pal73/FAT90/OUT_DOCS/1/1.png

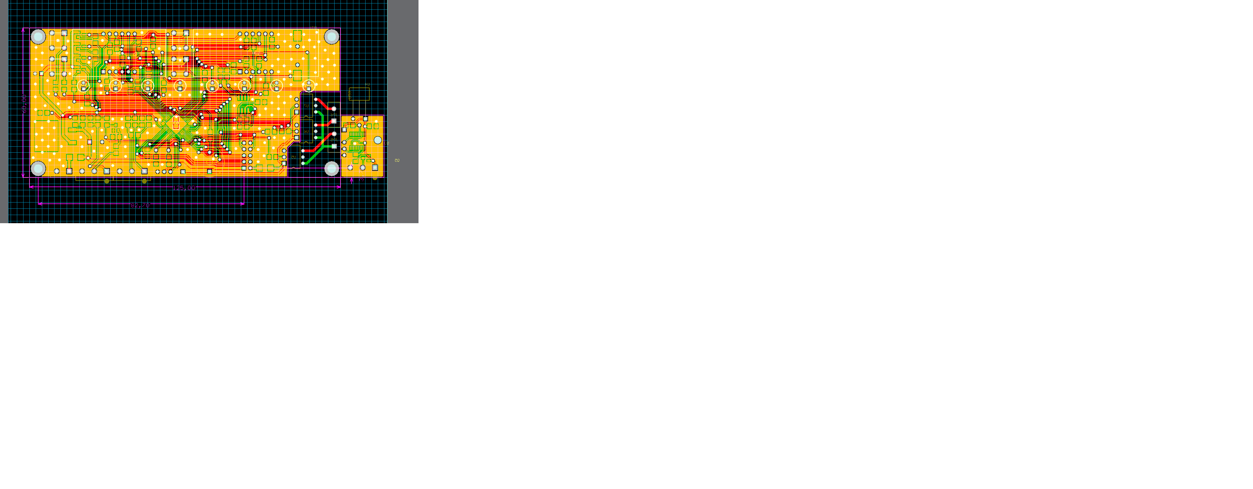
OUT_DOCS/1/1.png
