pal73/FAT90/OUT_DOCS/1/2.png

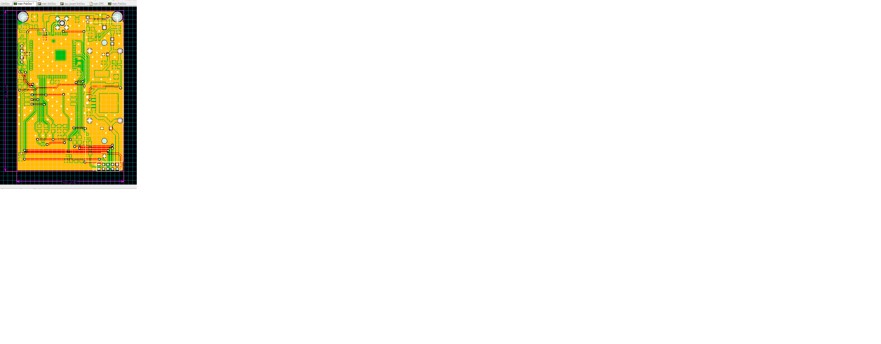
OUT_DOCS/1/2.png
