pal73/FAT90/(list of files, cad)

Other CAD files:
SOFT/dat/fat90_dat.stp
SOFT/kontr/fat90_kontr.stp
