pal73/FAT90/OUT_DOCS/1/7.pdf

NETLIGHT | 52 GND | 53 GND | 54 VBAT | 55 VBAT | 56 VBAT | 57 GND | 58 GND | 59 RF_ANT | 60 GND | 61 GND | 62 GND | 63 GNd | 64 GND | 65 STATUS | 66 GPIO11 | 67 GPIO12 | 68

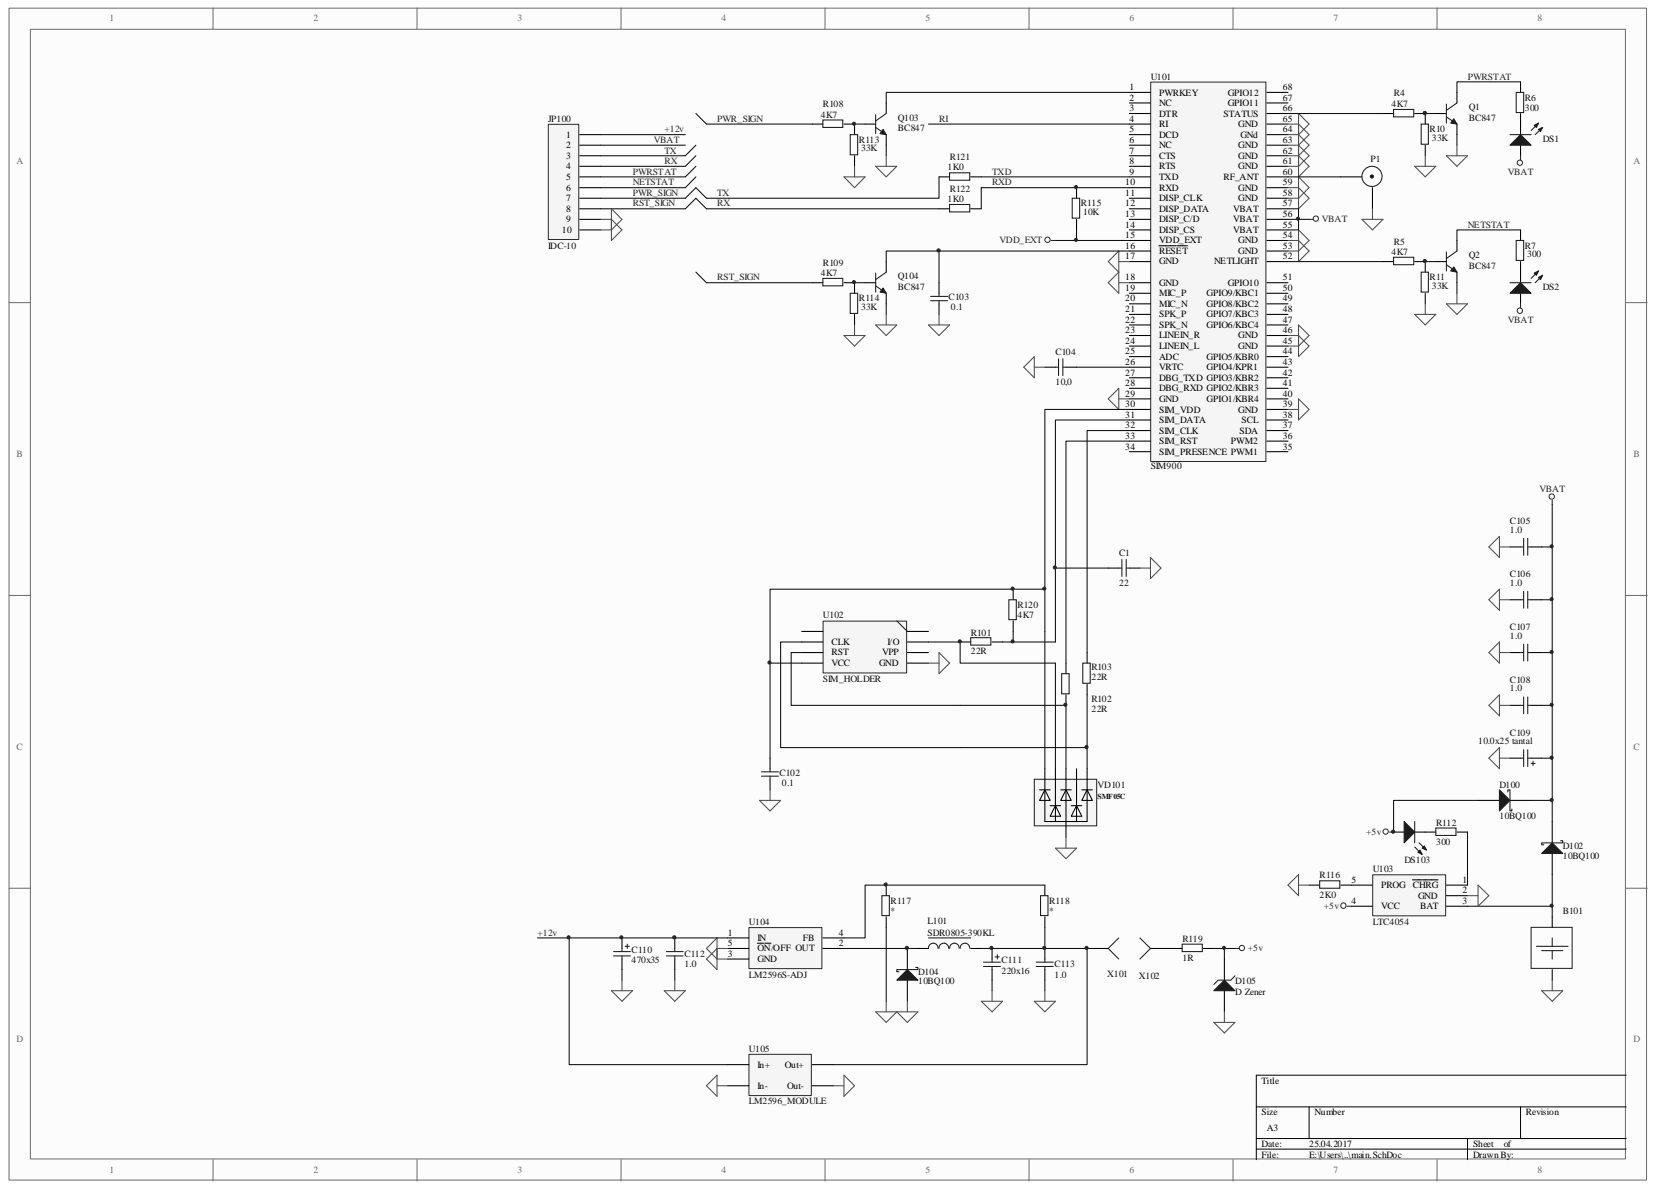
[picture p3: page 1]
