pal73/FAT90/OUT_DOCS/Thermo.PDF

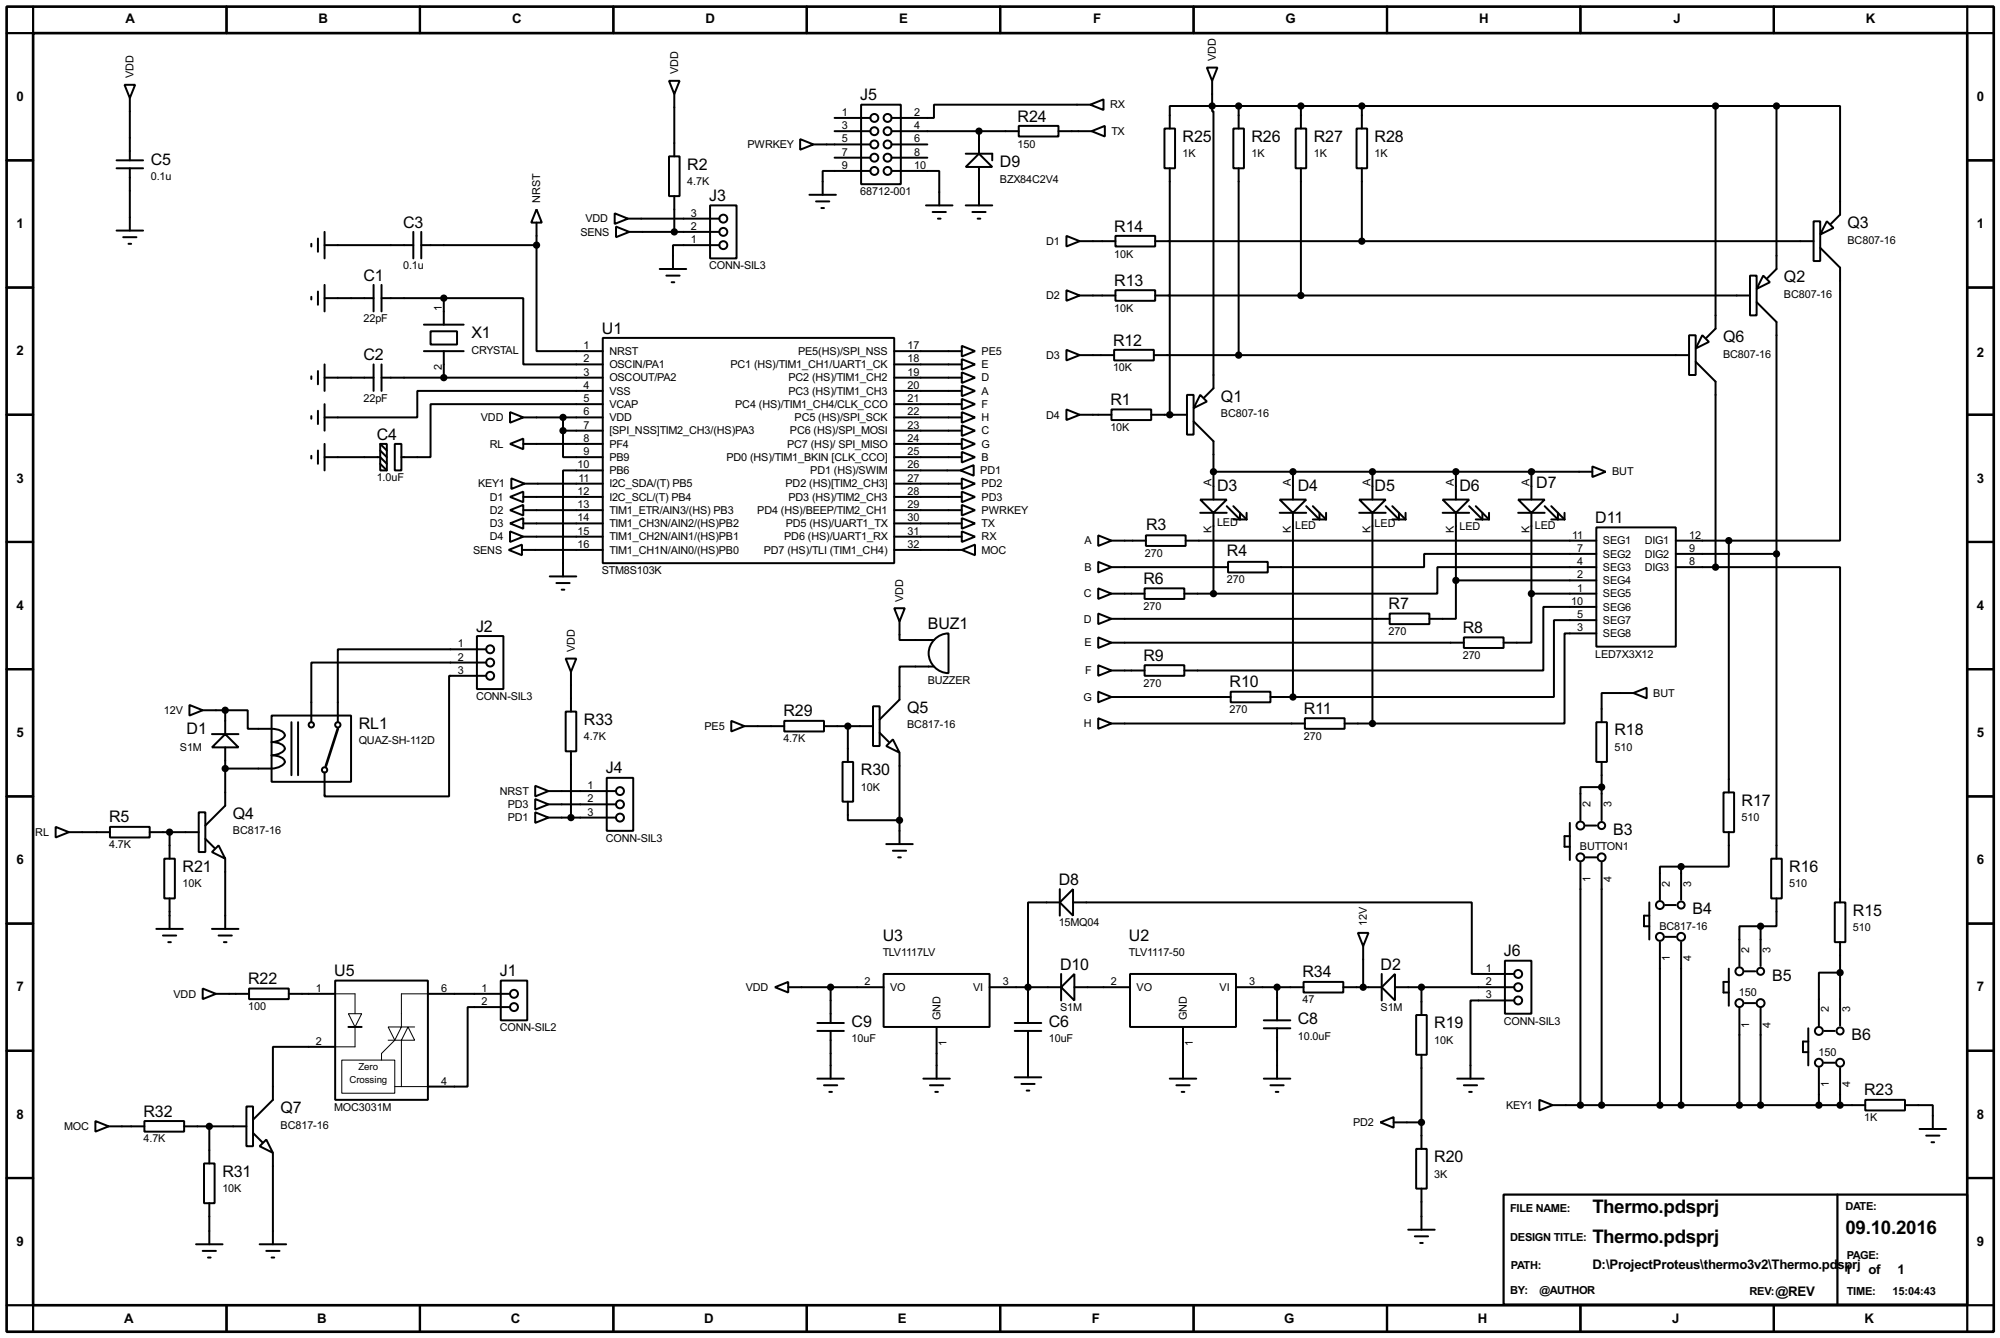
[picture p4: page 1]

FILE NAME:
DESIGN TITLE: Thermo.pdsprj
