pal73/FAT90/OUT_DOCS/1/3.pdf

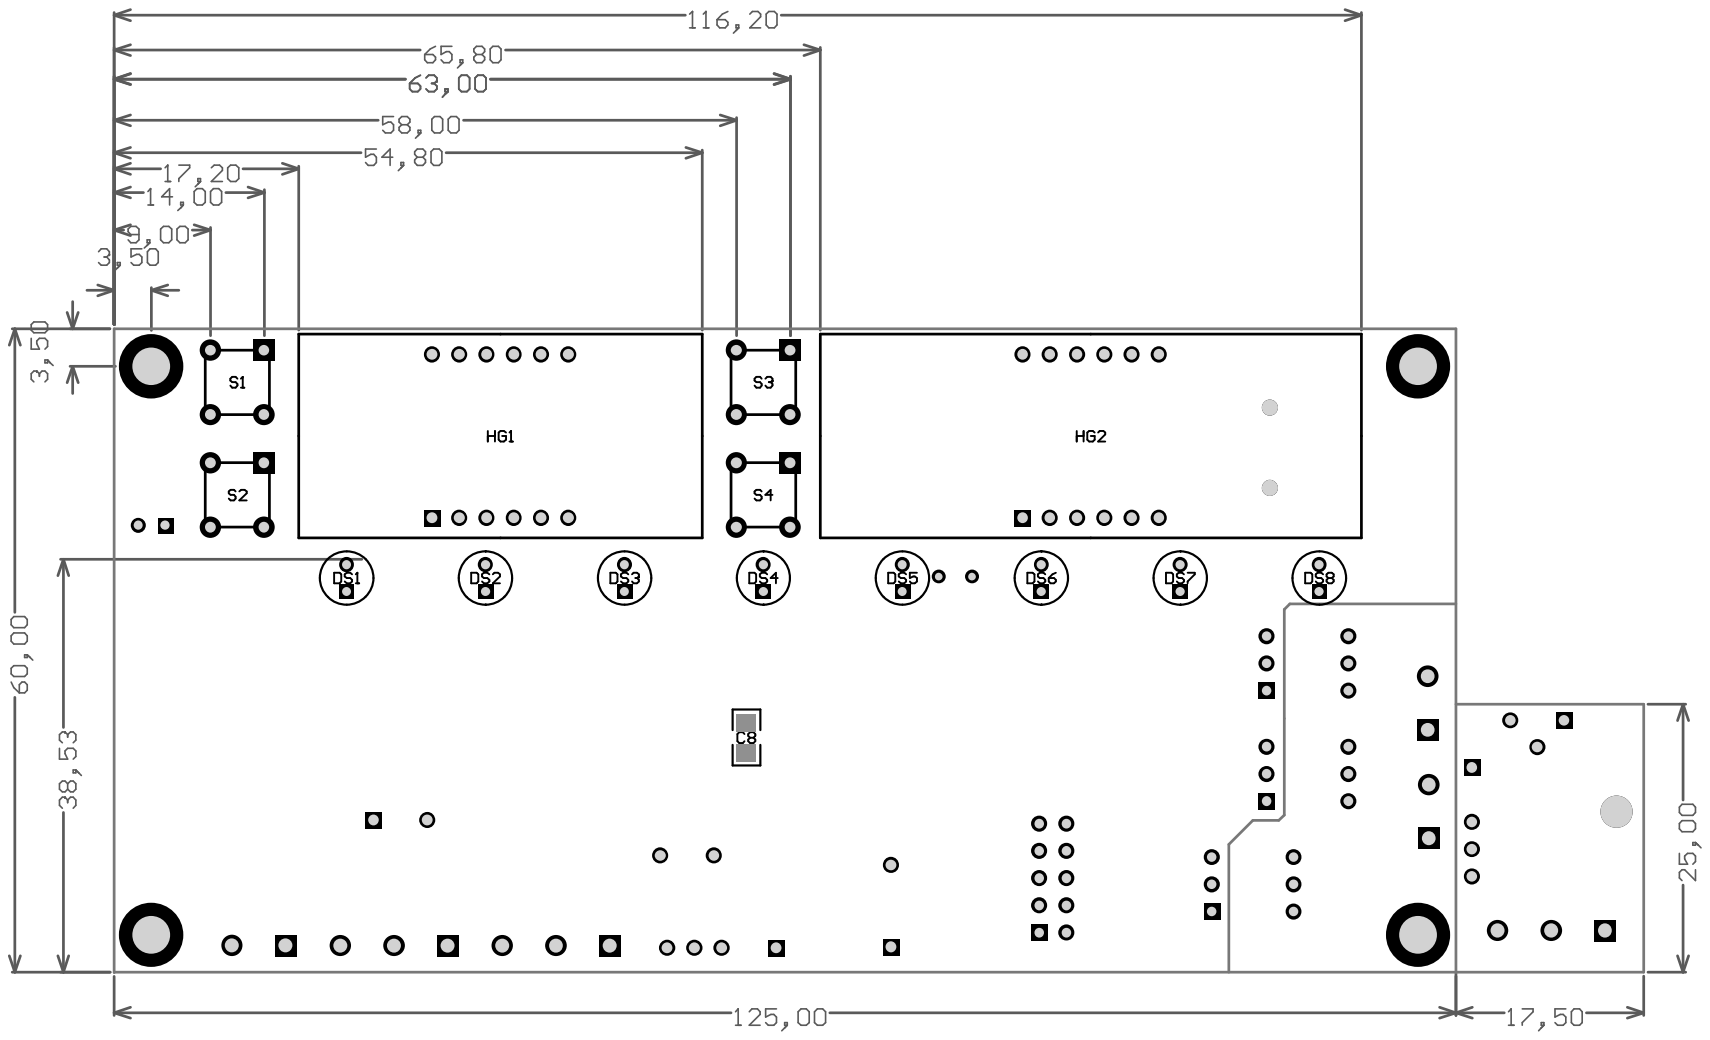
[picture p5: page 1]

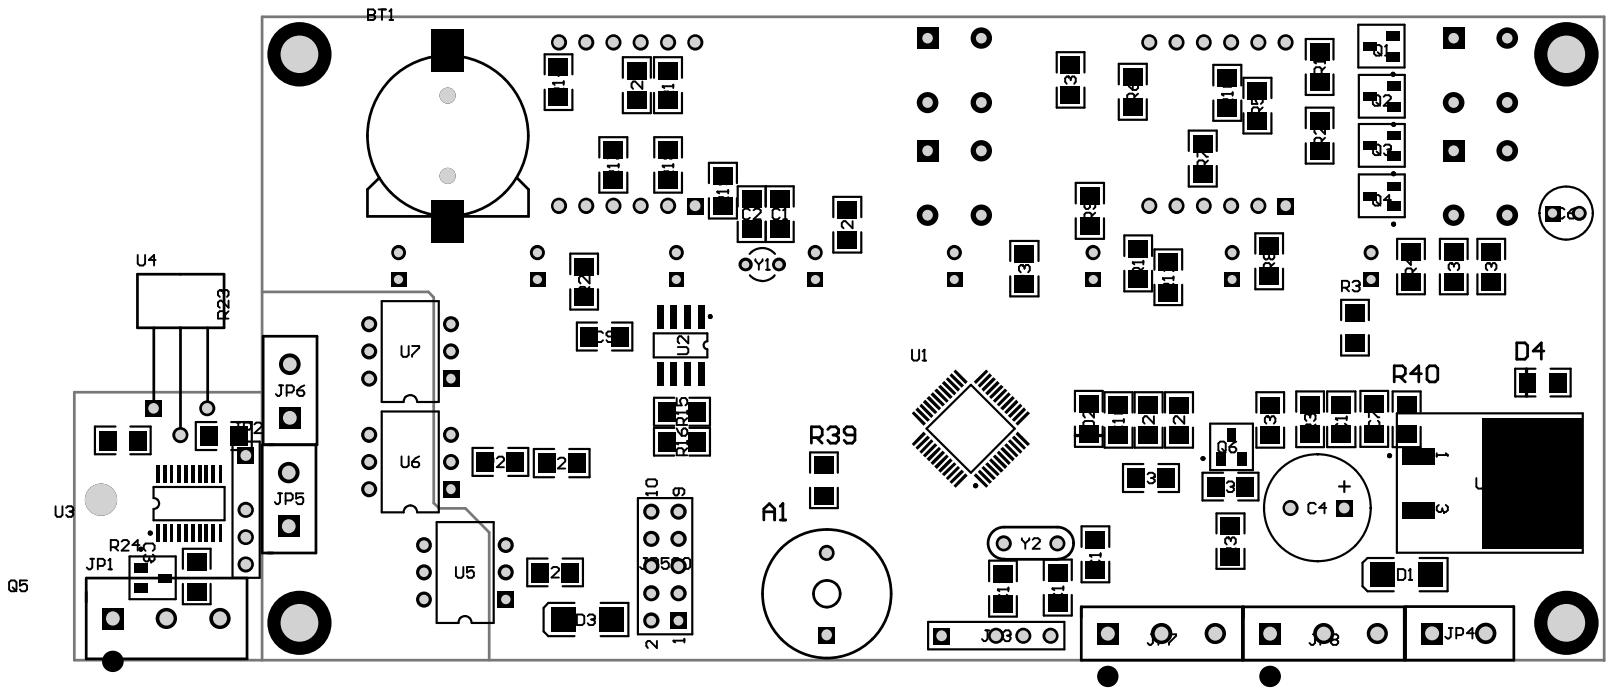
[picture p6: page 2]
