pal73/FAT90/OUT_DOCS/1/4.pdf

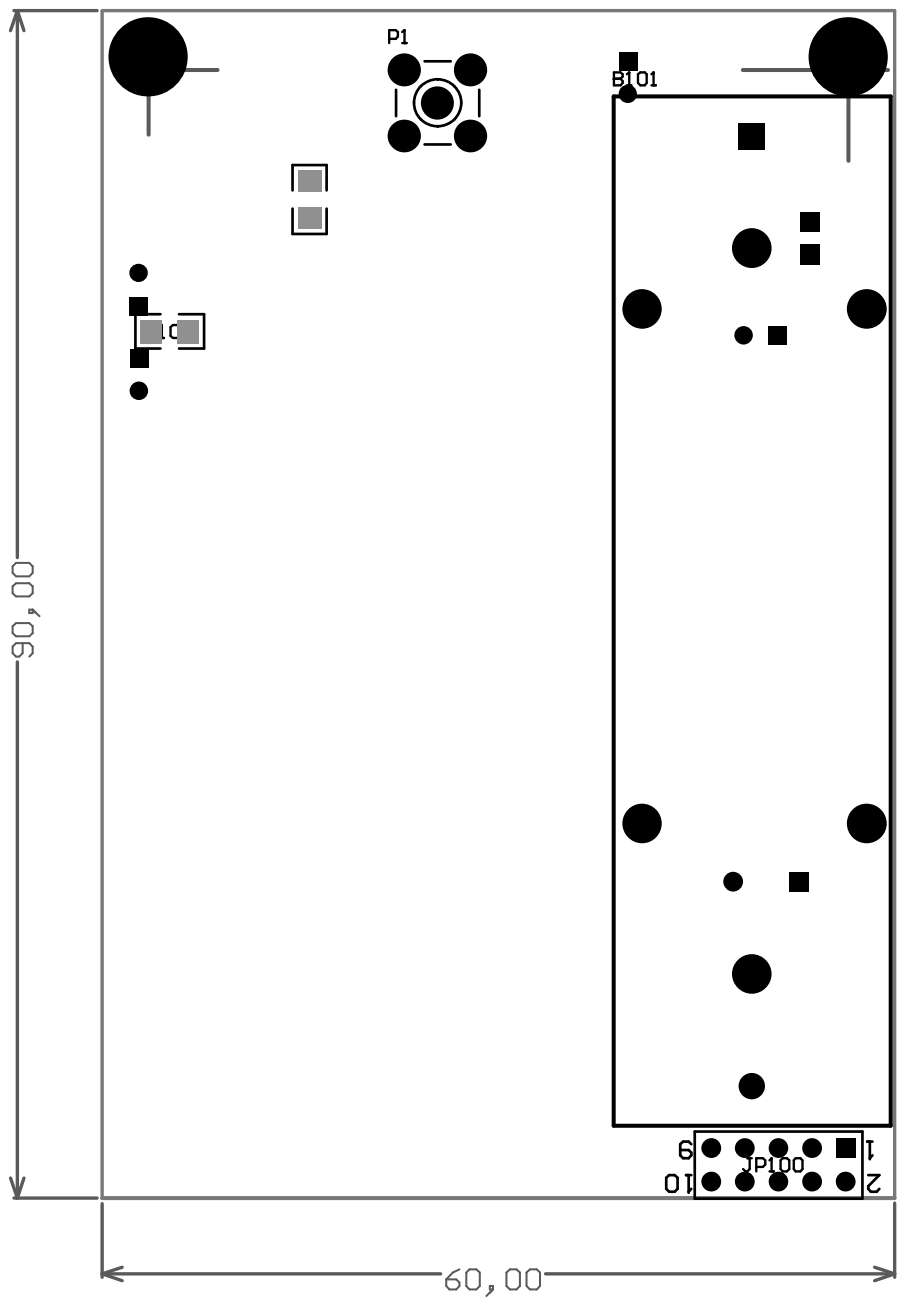
[picture p7: page 1]

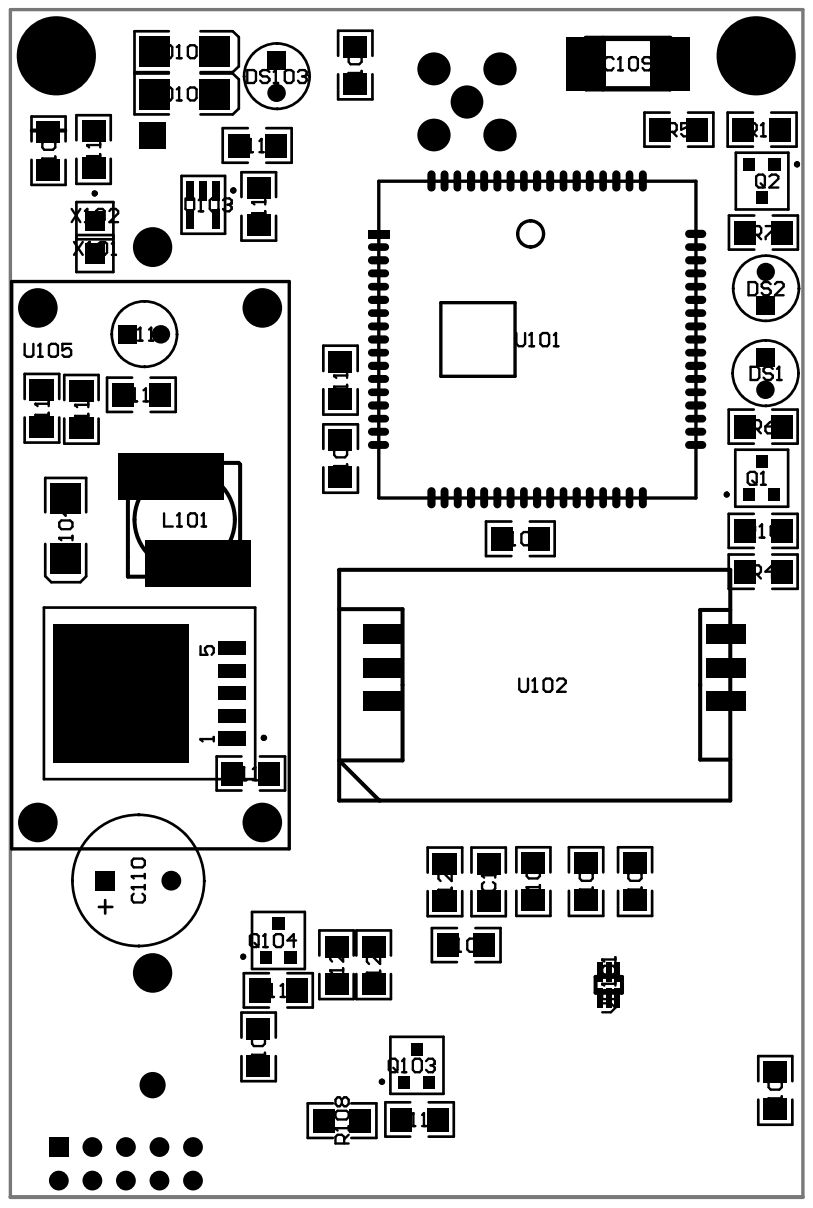
[picture p8: page 2]
