pal73/FAT90/OUT_DOCS/1/5.pdf

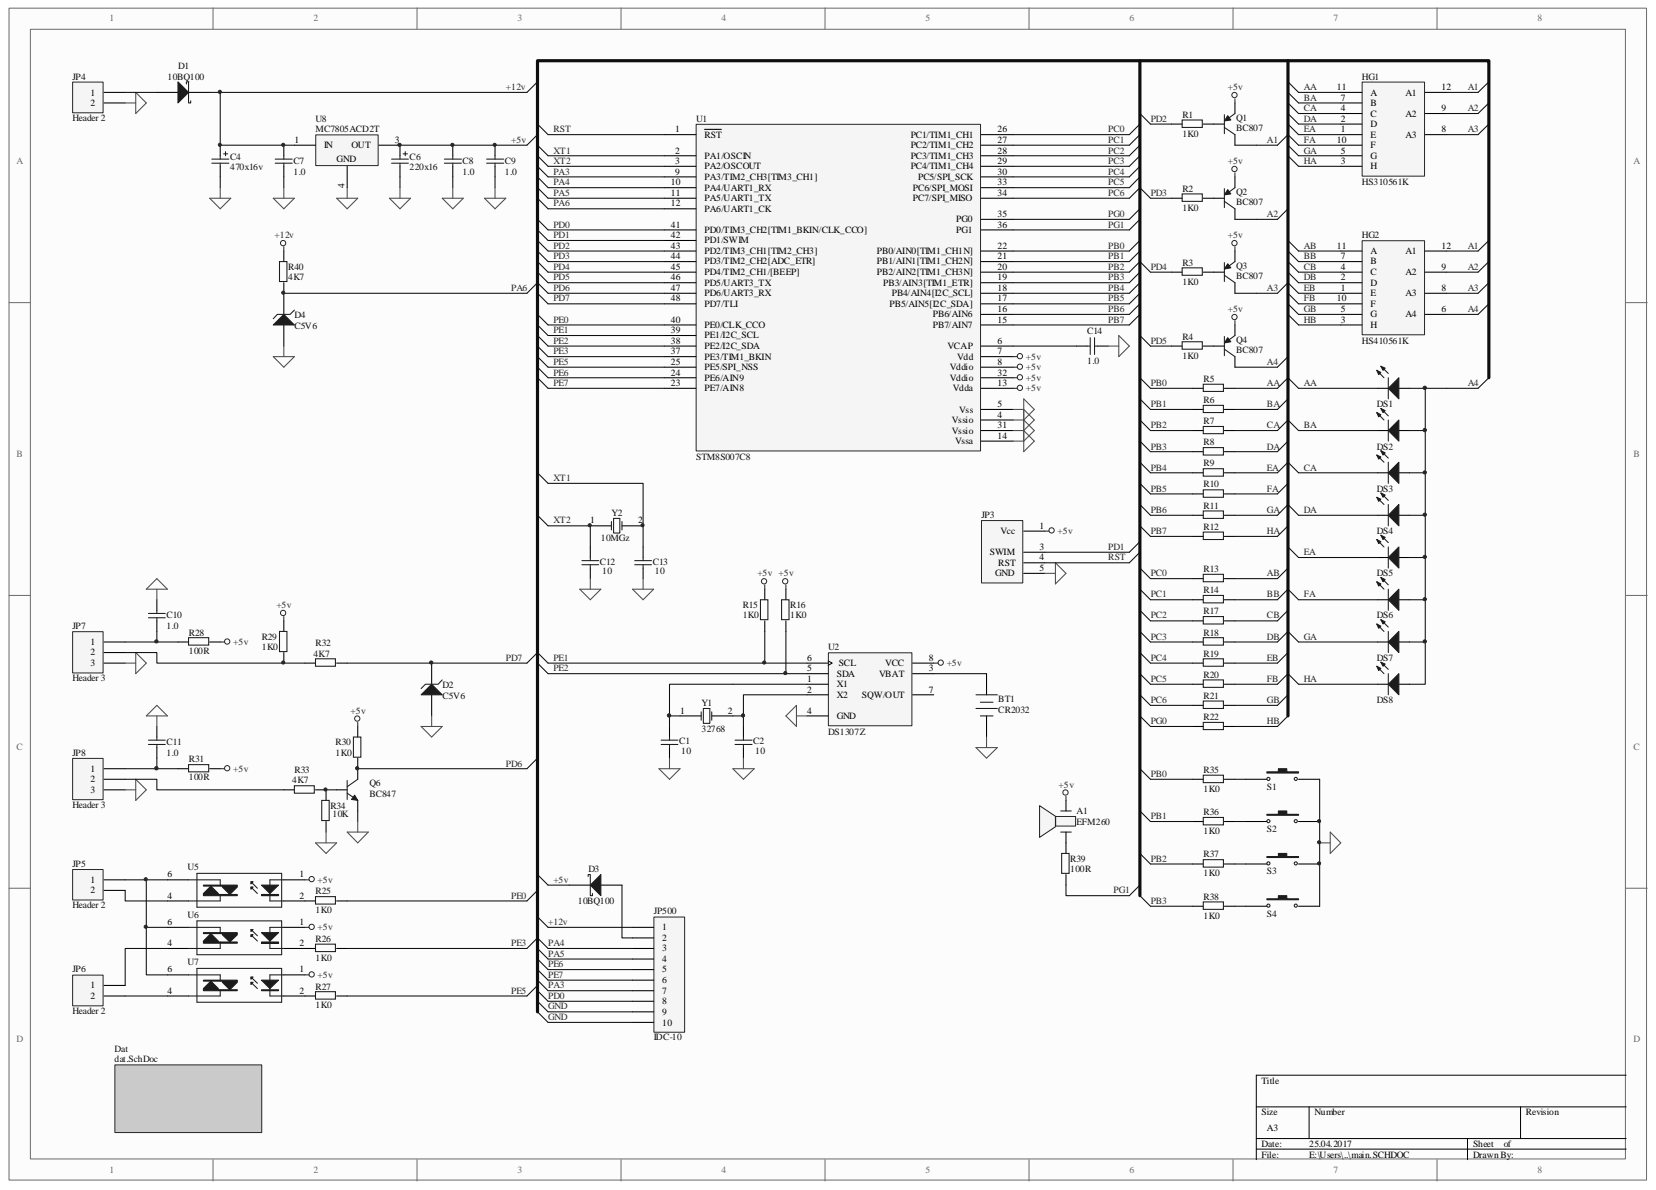
[picture p9: page 1]
