pal73/FAT90/OUT_DOCS/1/6.pdf

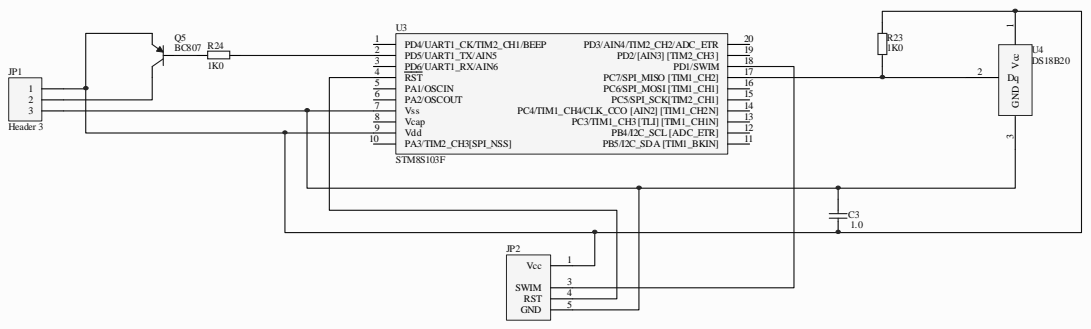
[picture p10: page 1]
