pal73/FAT90/(list of files, drawings)

Other design files:
HARD/KONTROLLER/am.SCHDOC
HARD/KONTROLLER/dat.SchDoc
HARD/KONTROLLER/KONTROLLER.PrjPCB
HARD/KONTROLLER/main.PcbDoc
HARD/KONTROLLER/main.SCHDOC
HARD/KONTROLLER/main_layout_complete.PcbDoc
HARD/KONTROLLER/main_m2.PcbDoc
HARD/KONTROLLER/sten_for_works.PcbDoc
HARD/MODEM/main.PcbDoc
HARD/MODEM/main.SchDoc
HARD/MODEM/main_layout_complete.PcbDoc
HARD/MODEM/MODEM.PrjPCB
