pal73/FAT90/SOFT/dat/main.h

#define __nop() _asm("nop")

extern char wire1_in[10];			//Считывание данных, буфер 1wire
extern char ds18b20ErrorHiCnt; 		//Счетчик ошибок по замыканию линии в "+" (или отсутствию датчика)
extern char ds18b20ErrorLoCnt;		//Счетчик ошибок по замыканию линии в "-" 
extern char ds18b20ErrorOffCnt;		//Счетчик нормальных ответов датчика
typedef enum {esNORM=0x55,esHI=1,esLO=0} enumDsErrorStat; 
extern enumDsErrorStat airSensorErrorStat;

//-----------------------------------------------
char wire1_rts(void);
