pal73/FAT90/(commit log)

2017-03-23 Старт проекта
2017-05-29 Обмен с платой датчика в сырЕ
2017-05-30 Читает 1307
2017-05-31 Меню установок на полпути
    [fat90_kontr.stp]
2017-06-01 Перестала показываться температура воздуха
2017-06-05 Режим по воде и рандом работают
2017-06-07 Не хватает работы по графику и отработки аварий и пищалки
2017-06-08 Уточнения в принципиалке контроллера
    [main.SCHDOC]
2017-06-12 Закбал гит
2017-06-12 ГИТ ЗАЕБАЛ!!!
2017-06-14 Отдаю 3 платы на испытание с этой программой
2017-06-15 Первый коммит ветки мастер после ответвления ветки модем
2017-08-14 Удаление soft90.wed
2017-08-14 изменил .gitignore
